audiodestrukt/freedj-nano/hw/puck/cad/renders/INDEX.md

# puck deck render log

- 0001-first-layout-hero.jpg .. 0004-first-layout-section-through-sensors.jpg: 2026-11-11: first layout, 65 dia x 33.1 mm. Waveshare 1.28" round touch LCD on a printed post; the whole top (ring round the glass + knurled side) is the jog, on one 61808 (40 x 52 x 7) with the inner race on the post. A 60-tooth comb under the hub runs through two ITR9608 slotted sensors (quadrature, 240 counts per turn) that stand up from the main PCB through the deck plate. XIAO S3 (USB-C out the back), 402030 LiPo, PCM5102A and jack (left side) in the bay under the plate.
  0001 hero, 0002 top, 0003 inside (face, screen and shell hidden), 0004 section through both sensors
