audiodestrukt/freedj-nano/hw/keychain/cad/renders/0001-first-layout-hero.jpg

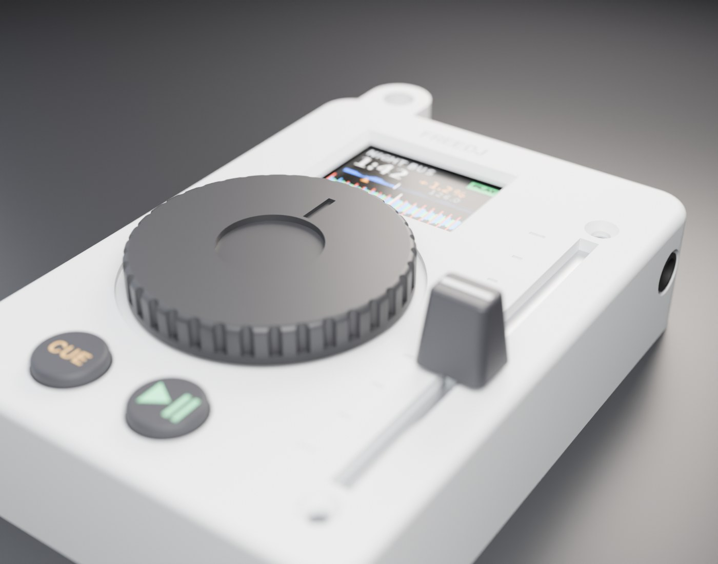
hw/keychain/cad/renders/0001-first-layout-hero.jpg
