audiodestrukt/freedj-nano/hw/keychain/cad/renders/0002-first-layout-top.jpg

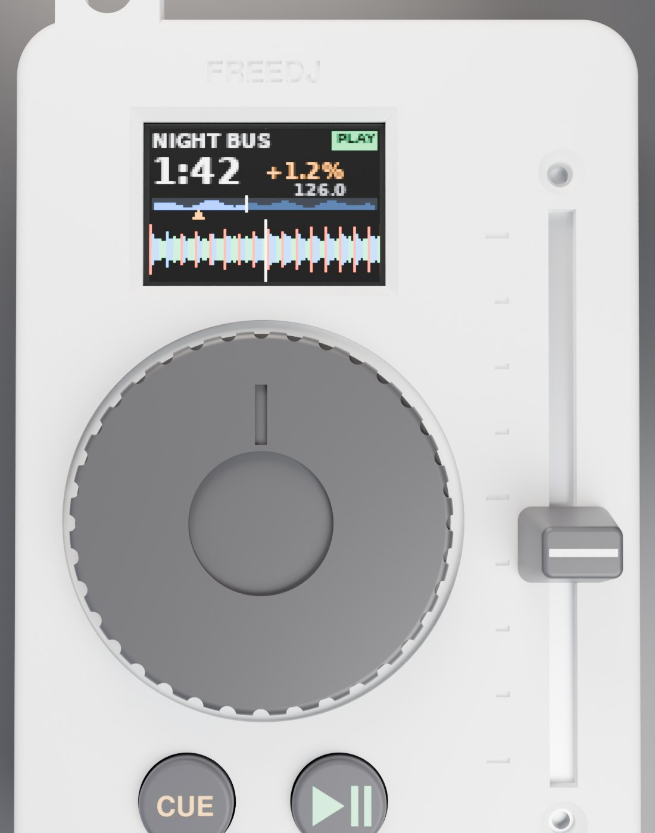
hw/keychain/cad/renders/0002-first-layout-top.jpg
