audiodestrukt/freedj-nano/hw/keychain/cad/renders/0003-back-usb-c-keyring.jpg

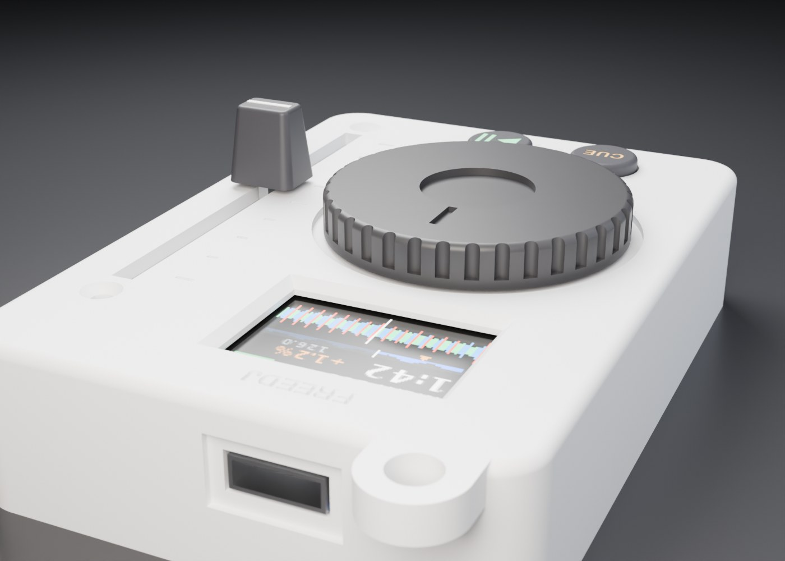
hw/keychain/cad/renders/0003-back-usb-c-keyring.jpg
