audiodestrukt/freedj-nano/hw/keychain/cad/renders/0004-inside-shell-hidden.jpg

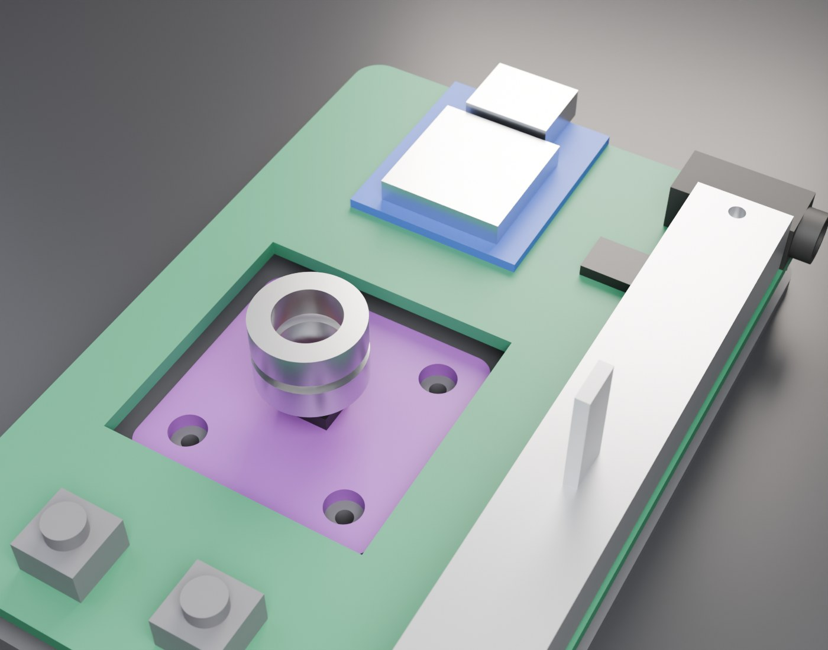
hw/keychain/cad/renders/0004-inside-shell-hidden.jpg
