audiodestrukt/freedj-nano/hw/keychain/cad/renders/0005-section-through-jog.jpg

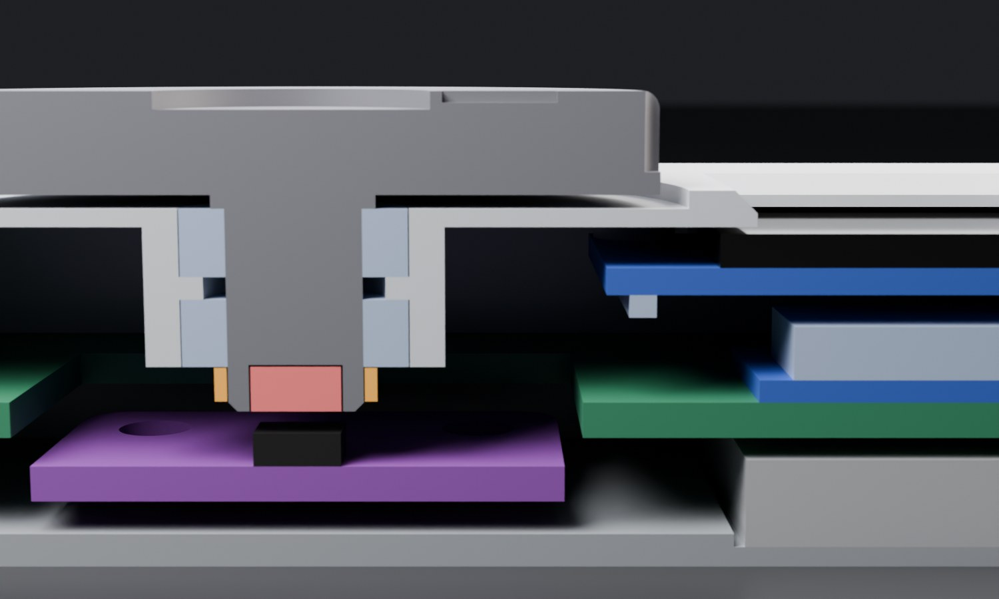
hw/keychain/cad/renders/0005-section-through-jog.jpg
