audiodestrukt/freedj-nano/hw/keychain/cad/renders/0006-cdj-layout-35mm-hero.jpg

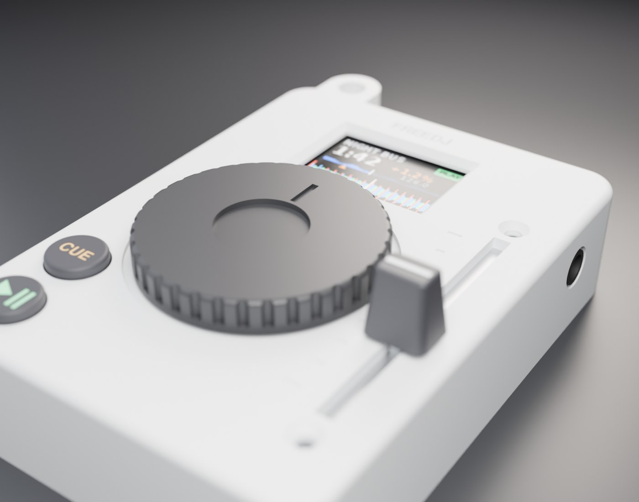
hw/keychain/cad/renders/0006-cdj-layout-35mm-hero.jpg
