audiodestrukt/freedj-nano/hw/keychain/cad/renders/0007-cdj-layout-35mm-top.jpg

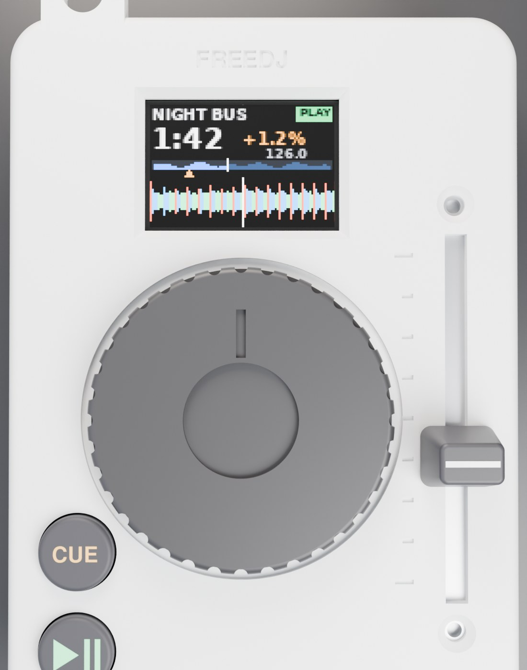
hw/keychain/cad/renders/0007-cdj-layout-35mm-top.jpg
