audiodestrukt/freedj-nano/hw/keychain/cad/renders/0008-cdj-layout-35mm-inside.jpg

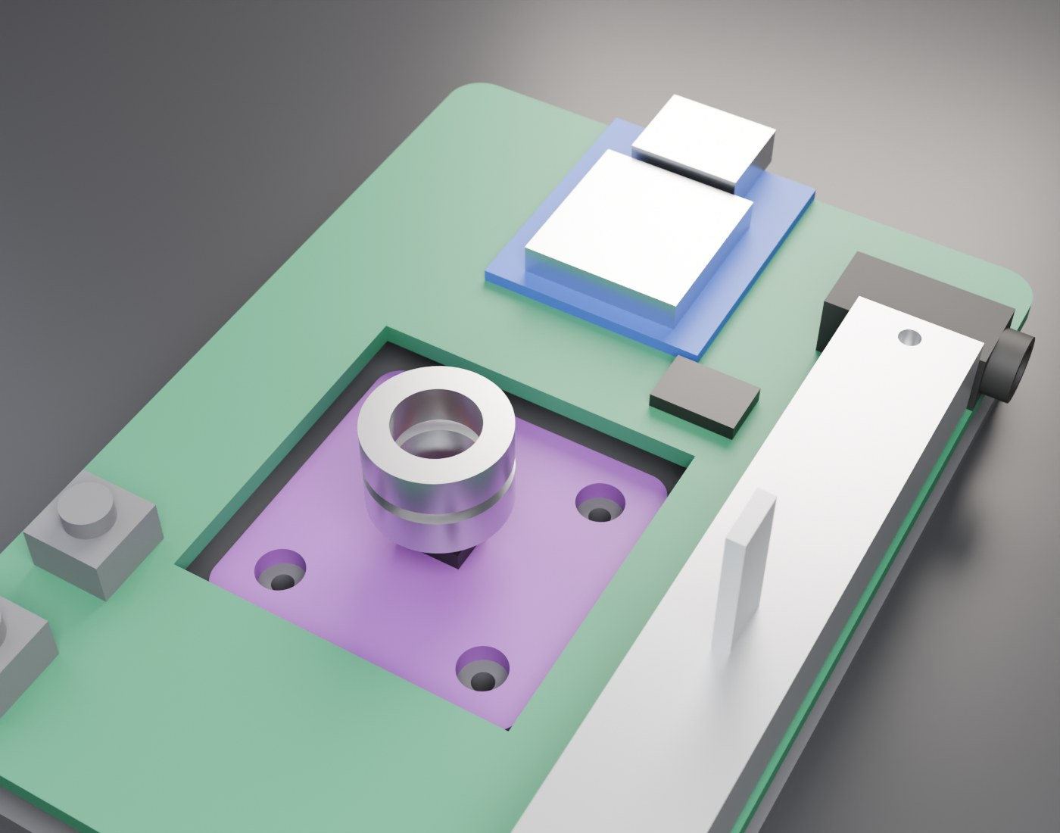
hw/keychain/cad/renders/0008-cdj-layout-35mm-inside.jpg
