audiodestrukt/freedj-nano/hw/keychain/cad/renders/0010-shell-underside-base-bosses.jpg

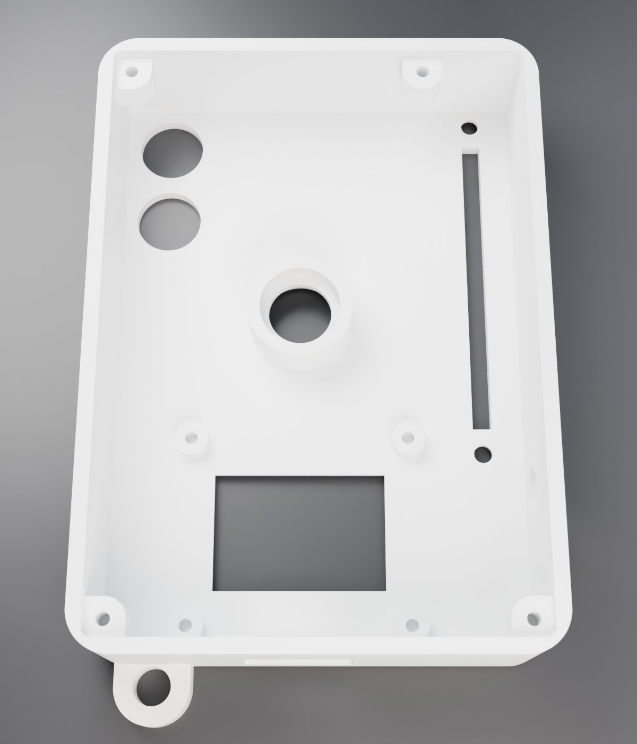
hw/keychain/cad/renders/0010-shell-underside-base-bosses.jpg
