audiodestrukt/freedj-nano/hw/keychain/cad/renders/0011-platter-in-line-with-play-hero.jpg

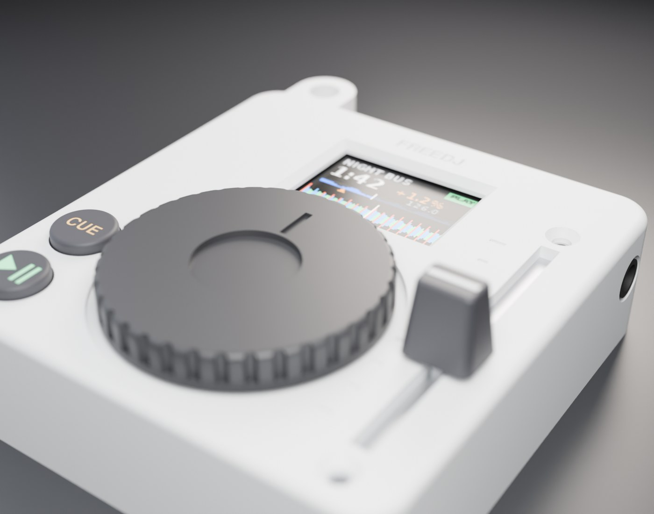
hw/keychain/cad/renders/0011-platter-in-line-with-play-hero.jpg
