audiodestrukt/freedj-nano/hw/keychain/cad/renders/0012-platter-in-line-with-play-top.jpg

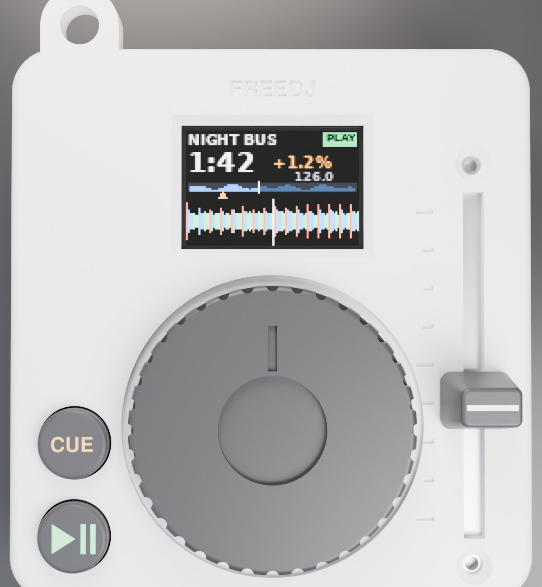
hw/keychain/cad/renders/0012-platter-in-line-with-play-top.jpg
