audiodestrukt/freedj-nano/hw/keychain/cad/renders/0013-platter-in-line-with-play-inside.jpg

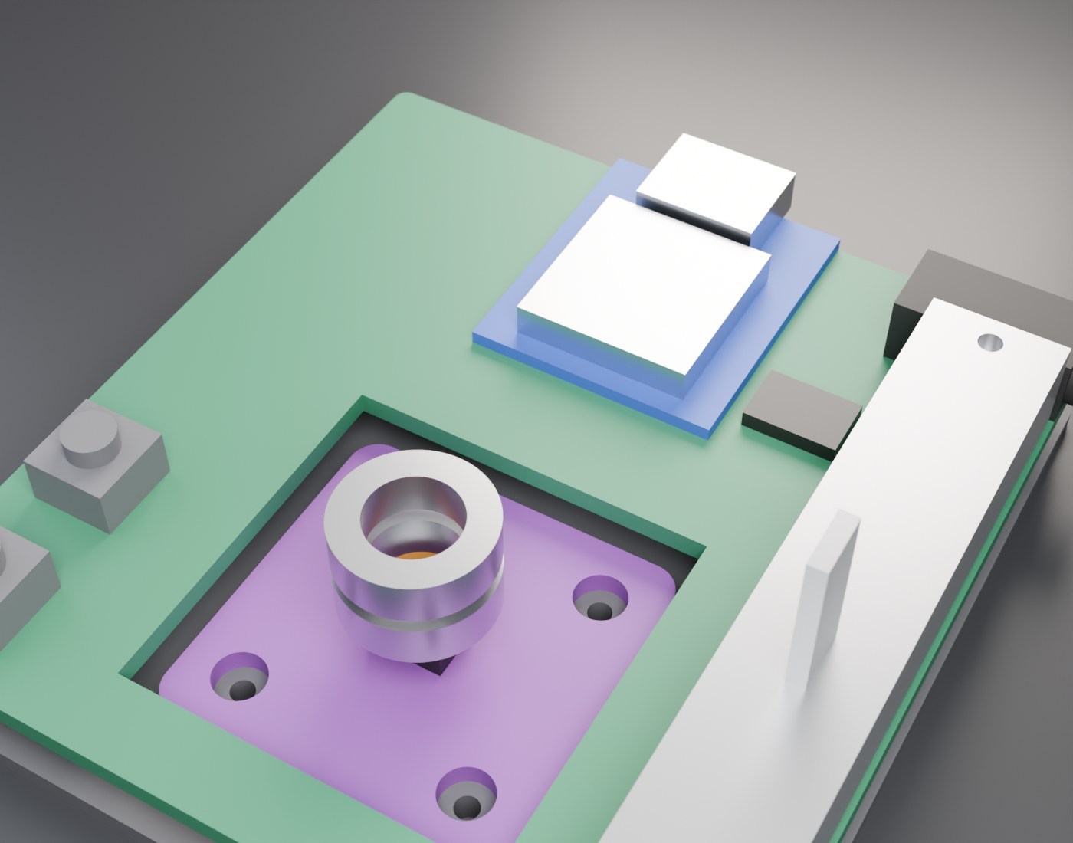
hw/keychain/cad/renders/0013-platter-in-line-with-play-inside.jpg
