audiodestrukt/freedj-nano/hw/keychain/cad/renders/0014-no-keyring-tab-hero.jpg

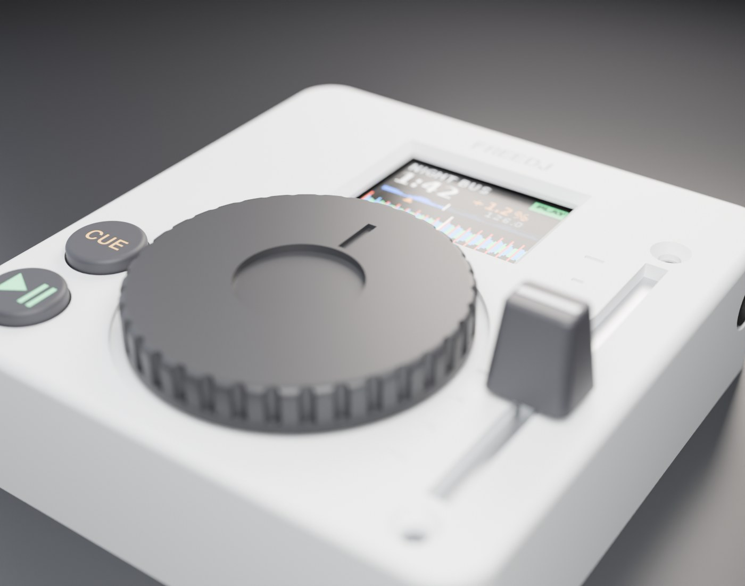
hw/keychain/cad/renders/0014-no-keyring-tab-hero.jpg
