audiodestrukt/freedj-nano/hw/keychain/cad/renders/0016-current-top.jpg

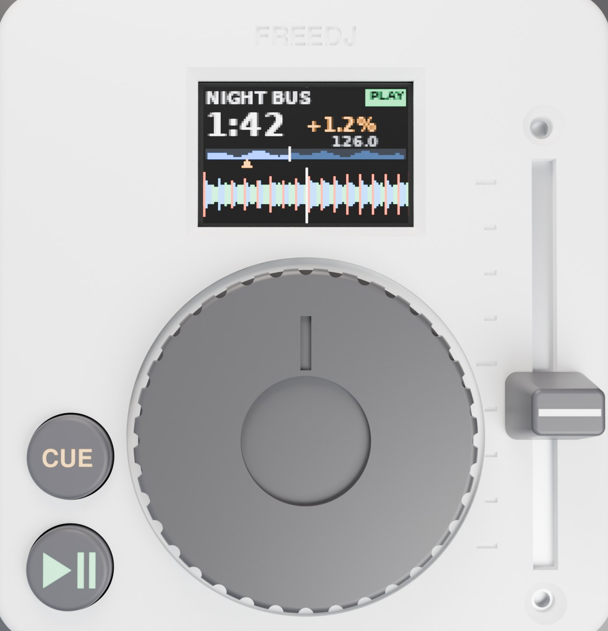
hw/keychain/cad/renders/0016-current-top.jpg
