audiodestrukt/freedj-nano/hw/keychain/cad/renders/0017-current-back-usb-c.jpg

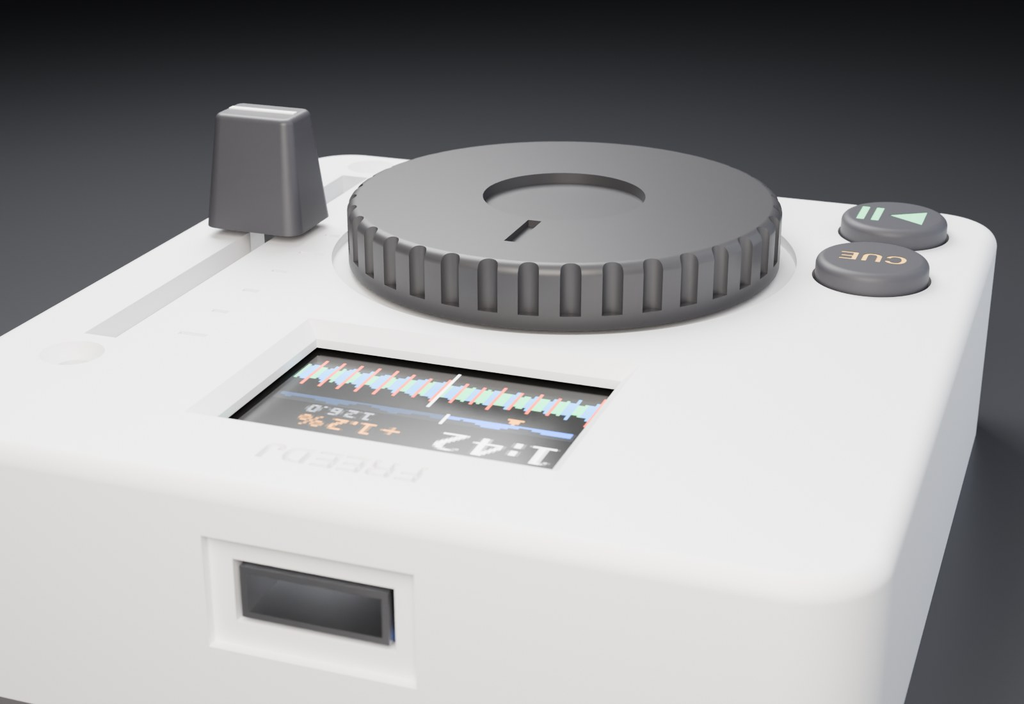
hw/keychain/cad/renders/0017-current-back-usb-c.jpg
