audiodestrukt/freedj-nano/hw/keychain/cad/renders/0018-current-right-side-jack.jpg

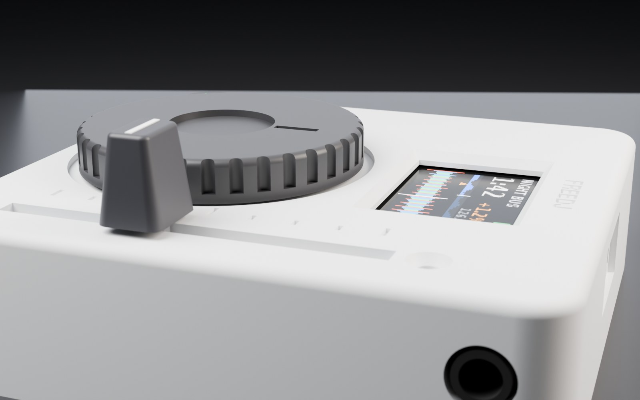
hw/keychain/cad/renders/0018-current-right-side-jack.jpg
