audiodestrukt/freedj-nano/hw/keychain/cad/renders/0019-current-inside-shell-hidden.jpg

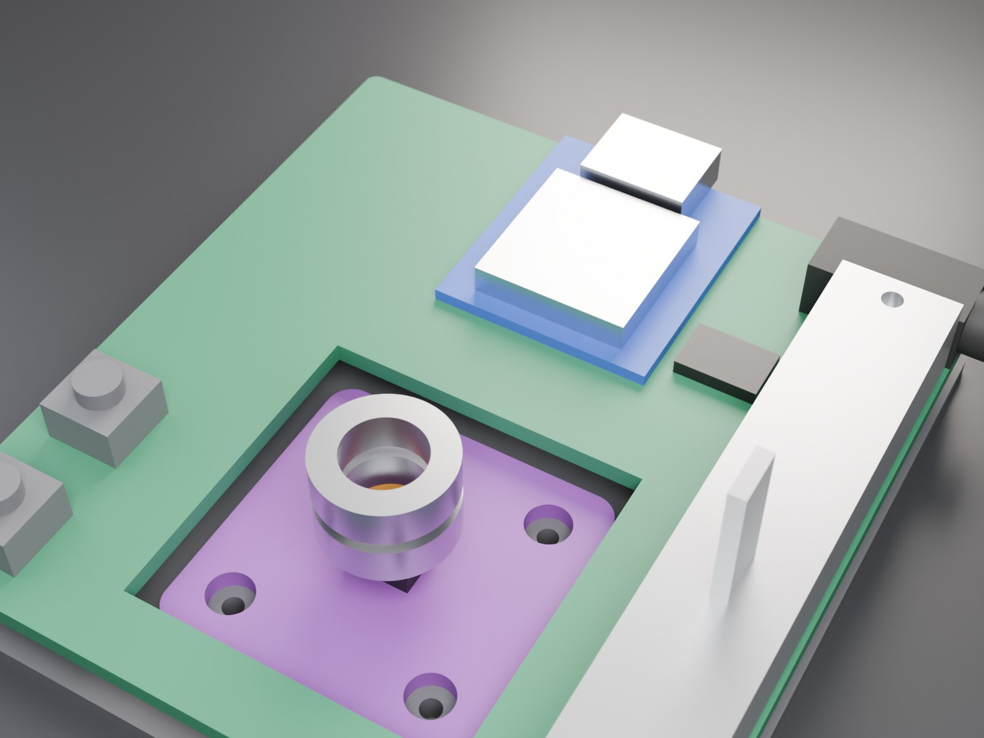
hw/keychain/cad/renders/0019-current-inside-shell-hidden.jpg
