audiodestrukt/freedj-nano/hw/keychain/cad/renders/0020-current-section-through-jog.jpg

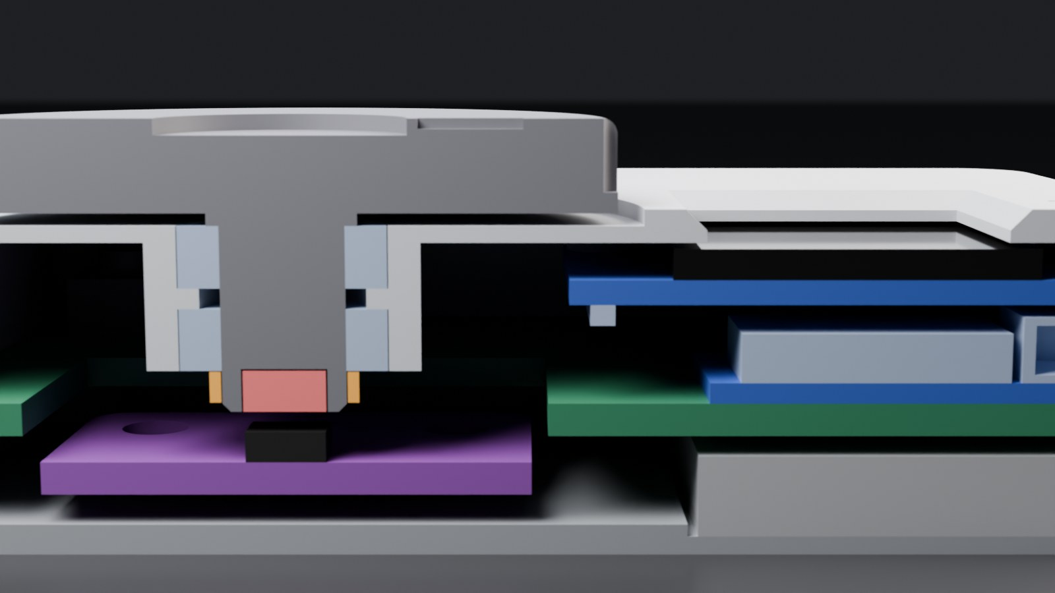
hw/keychain/cad/renders/0020-current-section-through-jog.jpg
