audiodestrukt/freedj-nano/hw/keychain/cad/renders/0021-current-shell-underside.jpg

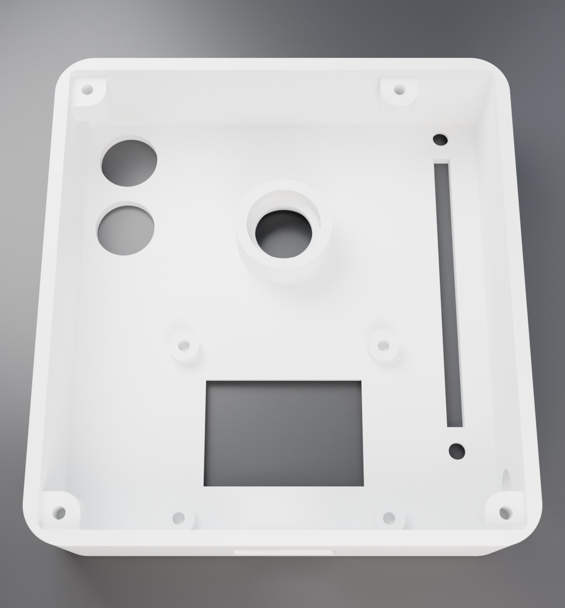
hw/keychain/cad/renders/0021-current-shell-underside.jpg
