audiodestrukt/freedj-nano/hw/keychain/cad/renders/0023-tft20-top.jpg

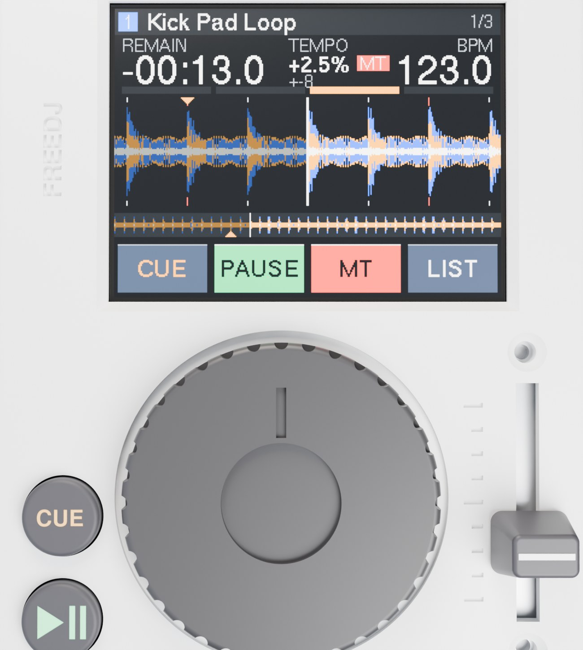
hw/keychain/cad/renders/0023-tft20-top.jpg
