audiodestrukt/freedj-nano/hw/keychain/cad/renders/0024-tft20-left-side-jack.jpg

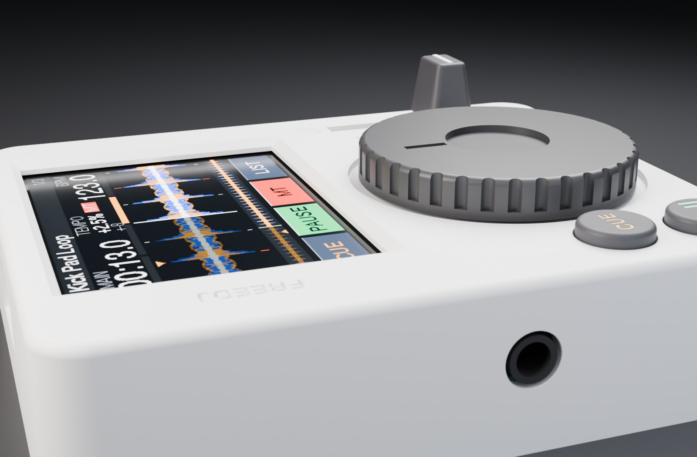
hw/keychain/cad/renders/0024-tft20-left-side-jack.jpg
