audiodestrukt/freedj-nano/hw/keychain/cad/renders/0030-centred-oled095-top.jpg

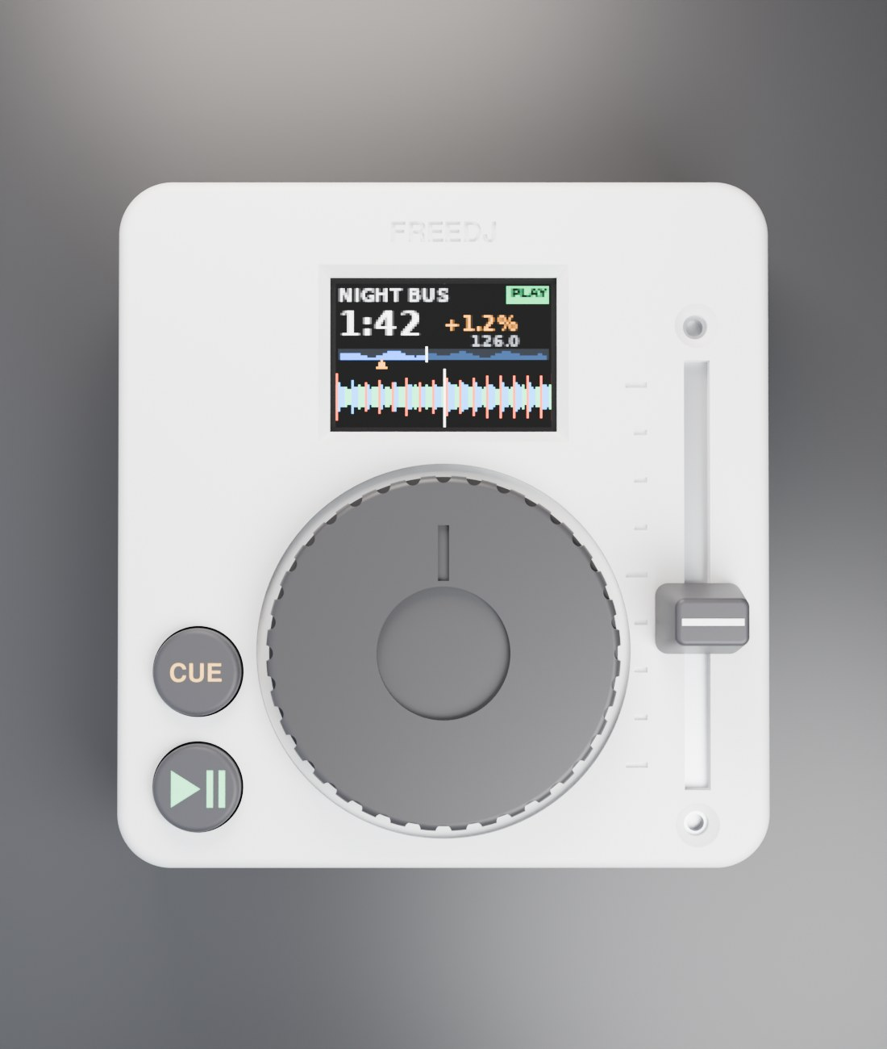
hw/keychain/cad/renders/0030-centred-oled095-top.jpg
