audiodestrukt/freedj-nano/hw/xiao-mini/fab/freedj-nano-xiao-mini-bom-pcbway.csv

Item# | Designator | Qty | Comment | Footprint | Manufacturer Part Number | Manufacturer | LCSC Part No
1 | C1,C8 | 2 | 10uF | capacitor_0805 | CL21A106KAYNNNE | Samsung Electro-Mechanics | C15850
2 | C10,C9 | 2 | 2.2nF | capacitor_0402 | CC0402KRX7R9BB222 | YAGEO | C106861
3 | C2,C3 | 2 | 2.2uF | capacitor_0603 | CL10A225KO8NNNC | Samsung Electro-Mechanics | C23630
4 | C4 | 1 | 1uF | capacitor_0402 | CL05A105KA5NQNC | Samsung Electro-Mechanics | C52923
5 | C5,C6,C7 | 3 | 100nF | capacitor_0402 | CL05B104KO5NNNC | Samsung Electro-Mechanics | C1525
6 | J1 | 1 | PJ_325C5_G | PJ_325C5_G | PJ_325C5_G |  | C692438
7 | J4 | 1 | S2B_PH_SM4_TB_LF__SN_ | S2B_PH_SM4_TB_LF_SN | S2B_PH_SM4_TB_LF__SN_ |  | C295747
8 | R10 | 1 | 4.7k | resistor_res0402 | ERJ2RKF4701X | Panasonic | C400631
9 | R1,R11,R4,R5,R6,R7 | 6 | 10k | resistor_res0402 | 0402WGF1002TCE | UNI-ROYAL(Uniroyal Elec) | C25744
10 | R9 | 1 | 2.2k | resistor_res0402 | 0402WGF2201TCE | UNI-ROYAL(Uniroyal Elec) | C25879
11 | SW5 | 1 | PEC11R_4015F_S0024 | PEC11R_4015F_S0024 | PEC11R_4015F_S0024 |  | C143789
12 | SW1,SW2,SW3,SW4 | 4 | TS_1187A_B_A_B | TS_1187A_B_A_B | TS_1187A_B_A_B |  | C318884
13 | U1 | 1 | PCM5102APWR | PCM5102APWR | PCM5102APWR |  | C107671
