audiodestrukt/freedj-nano/hw/xiao-mini/index.circuit.kicad_pcb

## KiCad design hw/xiao-mini/index.circuit.kicad_pcb (2026-11-10)

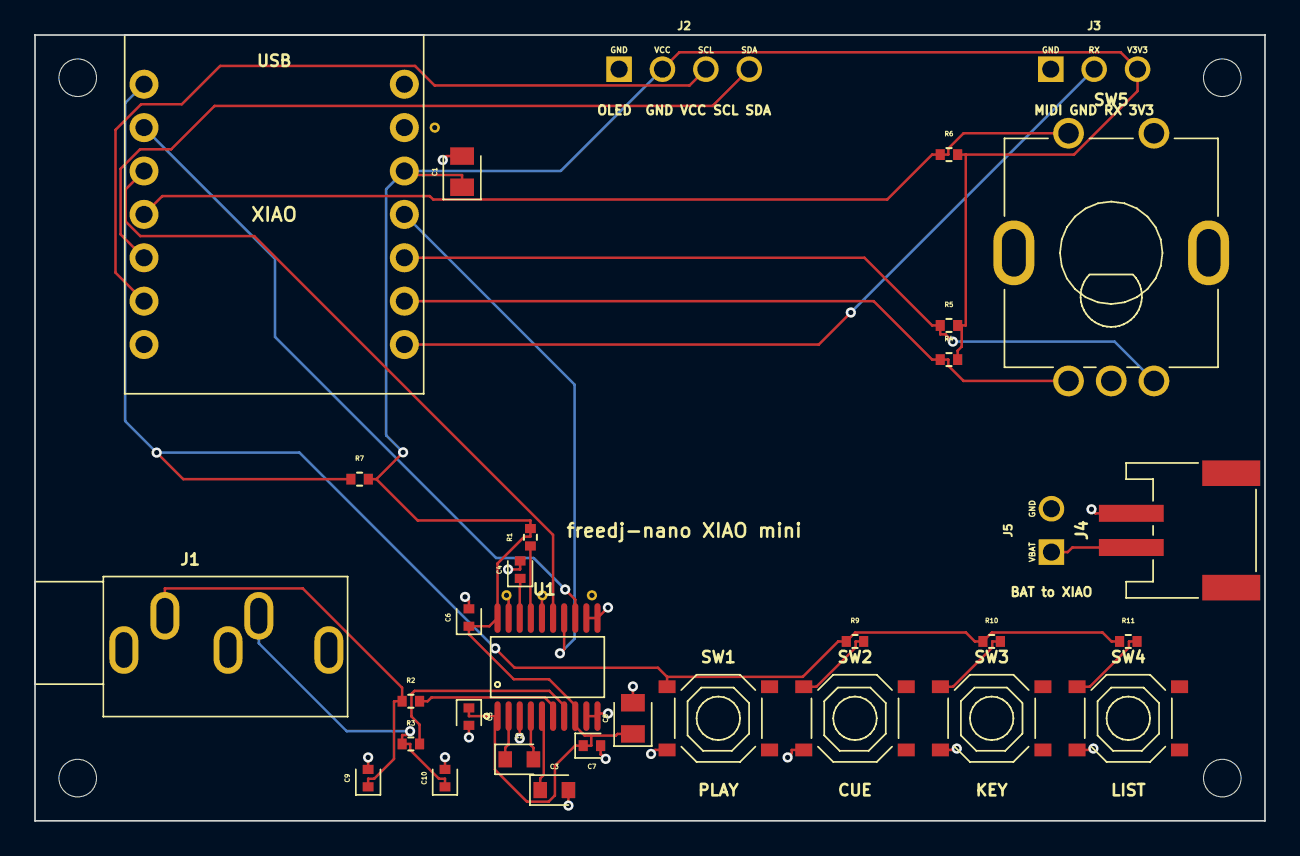
[picture p35: board index.circuit.kicad_pcb from above]

Board: 2 copper layers, 72.0 x 46.0 mm, 36 parts (0 on the bottom side), 25 nets.

Parts:
C1, C8: 10uF; capacitor_0805
C2, C3: 2.2uF; capacitor_0603
C4: 1uF; capacitor_0402
C5, C6, C7: 100nF; capacitor_0402
C9, C10: 2.2nF; capacitor_0402
J1: PJ_325C5_G
J2: J2; pin_header_pinrow4
J3: J3; pin_header_pinrow3
J4: S2B_PH_SM4_TB_LF__SN_; S2B_PH_SM4_TB_LF_SN
J5: J5; pin_header_pinrow2
R1, R4, R5, R6, R7, R11: 10kΩ; resistor_res0402
R2, R3: 470Ω; resistor_res0402
R9: 2.2kΩ; resistor_res0402
R10: 4.7kΩ; resistor_res0402
SW1, SW2, SW3, SW4: TS_1187A_B_A_B
SW5: PEC11R_4015F_S0024
U1: PCM5102APWR
U2: Seeed_XIAO_socketed
V1, V2, V3, V4: via

Connections:
BCK: U1.13, U2.2
C2.pin1 to U1.CAPP: C2.1, U1.2
C2.pin2 to U1.CAPM: C2.2, U1.4
C3.pin1 to U1.VNEG: C3.1, U1.5
C4.pin1 to U1.LDOO: C4.1, U1.18
DIN: U1.14, U2.11
ENC_A: R4.1, SW5.3, U2.13
ENC_B: R5.1, SW5.5, U2.12
ENC_SW: R6.1, SW5.1, U2.4
GND: C1.2, C3.2, C4.2, C5.2, C6.2, C7.2, C8.2, C9.2, C10.2, J1.1, J2.1, J3.1, J4.2, J5.2, SW1.3, SW2.3, SW3.3, SW4.3, SW5.2, SW5.4, SW5.6, SW5.7, U1.3, U1.9, U1.10, U1.11, U1.12, U1.16, U1.19, U2.9, V1.1, V2.1, V3.1, V4.1
JL: C9.1, J1.2, R2.1
JR: C10.1, J1.3, R3.1
LADDER: R7.1, R9.1, R10.1, R11.1, SW1.1, U2.1
LRCK: U1.15, U2.3
MIDI_RX: J3.2, U2.14
R1.pin1 to U1.XSMT: R1.1, U1.17
R2.pin2 to U1.OUTL: R2.2, U1.6
R3.pin2 to U1.OUTR: R3.2, U1.7
R9.pin2 to SW2.A: R9.2, SW2.1
R10.pin2 to SW3.A: R10.2, SW3.1
R11.pin2 to SW4.A: R11.2, SW4.1
SCL: J2.3, U2.6
SDA: J2.4, U2.5
V3V3: C1.1, C5.1, C6.1, C7.1, C8.1, J2.2, J3.3, R1.2, R4.2, R5.2, R6.2, R7.2, U1.1, U1.8, U1.20, U2.10
VBAT: J4.1, J5.1
