audiodestrukt/freedj-nano/(commit log)

2026-11-09 nano core (components/nano): fixed-point keylock (WSOLA reading memory-mapped PCM directly: 50% overlap sin^2, coarse+fine AMDF, ~40 B state; pitch, speed and level hold at 0.5/0.8/1.25/2x), varispee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
    [deck.h, deck_event.h, dj2go.h, gfx.h]
2026-11-09 firmware (ESP-IDF 5.5, ESP32-C6): I2S to PCM5102A (BCK 64 fs, no MCLK), EC11 on PCNT, GPIO or one-pin ladder buttons, pitch pot, DIN MIDI on UART1, tracks partition memory-mapped, u8g2 backend (SSD13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
    [partitions.csv]
2026-11-09 tools and docs: pack_tracks.py (ffmpeg -> track pack with 10 ms peaks, round-trips through the C++ reader), build.sh (all configs in Docker + host tests), README (scope vs freedj-esp, displays, pin m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
2026-11-09 firmware: serial bench console over USB (p/c/k/+/-/0/r/n/b/j/J/l/?), budget line shows state, track, position, tempo. First run on the XIAO ESP32C6: plays, cues, tempo and keylock from the console; a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
2026-11-09 xiao_tft: XIAO + 3.2" ILI9341 (SCK D8, MOSI D10, CS D3, DC D9, I2S DOUT to D6). Ladder pin pulled up (floating, it held CUE at boot). Banded TFT: layout skips work outside the band (was 15x), 48-row 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
    [board.h, display_tft.cpp, gfx.h, inputs.cpp]
2026-11-09 README: the XIAO drives the 3.2" touch TFT (xiao_tft: 28.5 fps, 17.6 ms/frame at 40 MHz), pin map; OLED + encoder stays the default XIAO build
2026-11-09 TFT: IPS voltage preset at boot on IPS panels (driver's TN defaults left sharp shadows of the waveform below it on the 3.2" ILI9341V), live tuning keys (i/v/V/f, R/a). Per-row change hashes: send onl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
2026-11-09 docs/DESIGN.md: design decisions and the thinking behind them (separate repo, fixed-point random-access keylock, own renderer + u8g2 for OLEDs, banded TFT steps 20 -> 53 fps, the ghosting chase to th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
2026-11-09 DESIGN.md: why Pro DJ Link is the tight fit (Wi-Fi bursts on the one core, flash writes stall memory-mapped tracks, wired = W5500 sharing the TFT's only SPI bus, Link over Wi-Fi jitter), and the test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
2026-11-09 CDJ-3000 look on the color layouts (freedj-esp palette): REMAIN / TEMPO + MT / BPM at tempo, beat-in-bar meter, 3-band waveform (blue/orange/white) with beat and bar ticks, coloured overview, key-sty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
2026-11-09 rekordbox: tools/rekordbox.py reads USBANLZ (PPTH path, PQTZ beat grid, PWV7 CDJ-3000 3-band waveform; byte order low/mid/high settled by correlation with our band filters). pack_tracks.py --rekordbo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
2026-11-09 docs/TARGETS.md: the RP2350 (second real target: two cores, XIP flash, PIO I2S, USB host; port plan per firmware module) and the CH32V003 (10-cent experiment: PWM audio, SPI flash, 2 KB RAM, keylock 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
2026-11-09 docs/DECK10C.md: plan for the 10-cent DJ deck on the CH32V003 (WCH-LinkE over SWIO, W25Q128 tracks via CH341A, dual-PWM audio, SSD1306 128x32 page renderer, EC11/buttons/pot, DJ2Go over the WCH-LinkE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
2026-11-09 DECK10C.md: microSD (SPI, Petit FatFs) as the default track storage, W25Q128 as the fallback; tracks stream forward through a ~0.6-1 KB ring (keylock's reads stay near the playhead, so no random seek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
2026-11-10 audio: I2S ws_width = 32 to match the 32-bit slots: the default (data width, 16) flipped WS mid-slot and the PCM5102A lost the right channel. First sound on the XIAO TFT build (BCK D1, LRCK D2, DIN D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
    [audio.cpp]
2026-11-10 stretch: search +-1 hop (11.6 ms) instead of +-hop/4 (2.9 ms): bass under ~200 Hz couldn't line up and followed the tempo (50-120 Hz 7.7-7.9 % sharp at +8 %), now within 0.25 % from 45 Hz up. Coarse 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
2026-11-10 ch32v003: nano-lite, phase 0 of the 10-cent deck. Engine in C for RV32EC: mu-law track through a 768 B ring + 192 B decimated copy, varispeed, keylock with the +-1 hop search clamped to the rings. 83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
2026-11-10 ch32v003: PWM output modelled; centre-aligned TIM1, R2 267k, Sallen-Key filter
    sim/pwm_sim.py (make pwm): two PWM pins, the 1:256 resistor sum (tolerances, pin
    resistance) and the filter solved exactly per PWM period; checked against tick
    stepping (4e-14 V) and ngspice (0.000 dB). THD+N at 1 kHz -6 dBFS:
    edge-aligned -47.8 dB (pulse centre moves with duty), centre-aligned -76.2 dB.
    At -40 dBFS: R2 255k -36.3, 267k -43.6; one 8-bit pin -14.1. mu-law track
    itself -37.6. Sallen-Key: ripple 55 -> 6 mVpp. 2x interp: 5 kHz image -26 -> -35 dB.
    [pwm_sim.py]
2026-11-10 nano-lite: lite_pos() continuous in keylock (was a hop behind at each hop's end)
    Found by the whole-deck sim: the reported position jumped back 231 frames every
    11.6 ms in keylock (i == 0 read as the start of the last hop, not its end), and
    by hop x (1 - speed) on a jump (-112 at 0.5x). Now ana + hop - (hop - i) x speed:
    continuous across hops and from a jump. Used for the display, cue points set
    while paused, the end of the track and engine switches. New test: position
    never goes backwards, keylock and varispeed, 0.5-1.5x. 93 checks pass.
2026-11-10 ch32v003/fw: the deck firmware behind a small HAL
    app.c: CDJ transport (CUE back to the cue / set and preview, PLAY), EC11 jog
    (nudge playing, search paused), SHIFT + turn list, push keylock, SHIFT + push
    tempo range, pitch pot, the DJ2Go over midi_bridge.py (0x01 + USB-MIDI) and
    console keys. ui.c: SSD1306 128x32, one page per step by DMA, 20 fps. sd.c: SD
    over SPI with a held-open CMD18 stream (SD_STREAM=0: CMD17 per read). tracks.c:
    TRACKS.BIN read by sector once it's found contiguous. pff/: Petit FatFs R0.03a
    (ChaN, 1-clause BSD), mount and open only, FAT32, plus pf_contig().
2026-11-10 ch32v003/sim: the deck on the computer, on emulated parts; 31 checks
    sim/emu: an SDHC card in SPI mode (CMD0/8/55/41/58/16/17/18/12, access time as
    0xFF bytes) and an SSD1306 from its I2C stream. sim/host: the firmware in an SDL
    window with sound, the panel on the keyboard, a pty for midi_bridge.py or the
    DJ2Go direct; headless scripted sessions (status lines, WAV, PNG screenshots).
    tools: pack_lite.py (TRACKS.BIN), sdimage.py (FAT32 image, MBR, 32 KB clusters,
    --fragment). test_sim.py: transport, search, preview, keylock pitch through the
    whole chain (440 Hz at +9.8 %), list, DJ2Go, console keys, end of track,
    fragmented file, no card. SD at 1x: CMD18 stream 32 KB/s (1 % of the bus) vs
    CMD1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
2026-11-10 ch32v003: whole firmware counted in qemu (make deckbench); fits, 14 % CPU
    The same firmware for RV32EC with the emulators linked in and left out of the
    count, a 10.5 s scripted session; SPI byte wait charged as instructions. At 1.5
    cycles/instruction: flash 10.8 KB (+ ~1.5 KB drivers = ~12.1 of 16 KB), RAM
    1403 B + 256 B DMA ring + 364 B stack = 2023 of 2048 B, CPU 14 % (engine 9 %),
    worst main-loop step 95 k instructions = 68 % of the ring (list view).
    CMD17 reads instead: 66 % CPU, worst step 303 %: audio would drop.
2026-11-10 ch32v003: 128x64 OLED (0.96"): big time, beat meter, cue time, 7-row list
    Same one-page buffer, so no more RAM for twice the screen. Pages: name; time
    left at 2x with BPM at tempo and tempo; state, inverted KEY, range; four-beat
    bar meter from the beat grid; elapsed and cue; 16 px overview. List: header +
    7 names. SSD1306 emulator follows the multiplex ratio (64 or 32 rows).
    deckbench: flash 11.5 KB (+0.6), RAM 2027/2048 B (+4), CPU 15 % (+0.5), worst
    step 105 k instructions = 75 % of the ring (list view, was 68 %). 31/31 sim.
    [app.c, app.h, main.c, ui.c, ui.h]
2026-11-10 ch32v003: scrolling waveform; deckbench cycle model; CPU and fps in the sim
    Waveform on pages 4-6: 1.5 s around the playhead, 23 px mirrored, min 1 px,
    beat ticks, cue notch; peaks (1 per 256 frames) read from TRACKS.BIN into the
    page buffer, no RAM. Petit FatFs state borrows the page buffer at mount: RAM
    1998/2048 B. deckbench cycle model (flash wait state, loads, taken branches):
    2.57 CPI, 37 % CPU, worst step 135 % of the ring -> audio would drop (two SD
    stream restarts per waveform page); without the waveform 22 % / 91 %. Sim
    window: estimated CPU (35.5 % vs 37 %), worst step, fps. 31/31 sim checks.
2026-11-10 nano-lite: play backwards (negative speed, varispeed) for scrubbing
    A backwards read below the 35 ms ring refills it with the playhead near its top:
    one forward card read per ~700 frames back. Forward reads below the ring still
    count as misses. Tests: 440 Hz backwards at 1x, 2.5x, 0.3x (pitch within 1 %,
    travel within 64 frames, no misses, no steps beyond the tone's own), and a 2 s
    back-and-forth scratch at 3x returns to within 300 frames. 106 checks.
2026-11-10 docs: DECK10C-CONTROLS.md, jog / browse / button options for the CH32V003 deck
    Undecided, written up: 16 of 16 pins used (pot on PD5, the unused USART TX).
    Jog: EC11 (80-120 counts, 3 pins), AS5600 on the shared I2C (4096, 0 pins),
    or a slotted printed wheel + two slot sensors on TIM2 encoder mode (4N counts,
    ~300-400; 2 pins, no CPU; sensors (k + 1/4) pitches apart). Side thumbwheel
    for browse; binary-weighted resistor ladder for the buttons (CUE + PLAY must
    read). Pin plans for each; a one-turn DJ2Go test.
2026-11-10 docs: CHIPS.md, chip options and what each would sound like
    CH32V003 limits (2 KB RAM, no I2S, no multiply, 16 pins, no USB host) against
    CH32V002 / V006 (8 KB) / V203 (20 KB+, 144 MHz, USB host, 2 SPI, no I2S per its
    tables) / V30x (I2S, FPU) / RP2350. Scenarios: V003 as is; V006 for 16-bit mono
    or safety margin; V203 + PCM5102A for 16-bit stereo 44.1 kHz via SPI + a timer
    for LRCK, DJ2Go on the USB host; V30x; RP2350. Things to check before choosing.
2026-11-10 hw/xiao-mini: carrier board for the XIAO ESP32-C6 deck (routed, DRC clean)
    72 x 46 mm, 2 layers, tscircuit source routed headless (pcb-layout route2: Freerouting
    through KiCad, srj compared). Wires the C6 firmware's XIAO OLED pin map: PCM5102A -> 3.5 mm
    line out (D1/D2/D10), OLED header (D4/D5), EC11 + push (D8/D9/D3), 4-button ADC ladder on D0
    (0/2k2/4k7/10k), MIDI-in header (D7), JST-PH LiPo + pads to the XIAO's BAT pads.
    Result: 0 shorts, 0 open, 0 DRC errors (JLCPCB rules), DFM clean, no floating pads; 25 vias,
    762 mm of track. fab/: Gerbers, drill, CPL, JLCPCB + PCBWay BOMs (20 parts assembled).
    To check before ordering: jack pinout (assumed 1 sleeve / 2 tip / 3 ring), OLED pin order,
    a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
    [freedj-nano-xiao-mini-bom-pcbway.csv, freedj-nano-xiao-mini-bom.csv, freedj-nano-xiao-mini-handsolder.csv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]
2026-11-11 hw/keychain: pocket deck enclosure for the XIAO ESP32-S3 (CDJ layout, fit-checked)
    60 x 63.6 x 16.9 mm build123d enclosure: 0.95" colour OLED over a 32 mm jog on two
    MR106ZZ and the AS5600 breakout, CUE over PLAY bottom-left with the platter in line
    with PLAY, 35 mm pitch fader from the front edge, LiPo, PCM5102A + jack, USB-C out
    the back. make builds the STLs and checks all 28 parts for overlap (none). Renders
    and their log in cad/renders/.
2026-11-11 hw/puck: round deck, whole top is the jog on a 61808, opto comb encoder (fit-checked)
2026-11-11 hw/cad: make installs its own deps, builds and renders on macOS
    - hw/cad.mk (shared by both CAD Makefiles): creates hw/.venv from
    cad-requirements.txt on first make (uv with Python 3.12 if present),
    finds Blender on PATH / macOS / the old Linux path. PY=... skips the venv.
    - machine.py: fit check works on build123d 0.13 (no Vector.to_tuple, a
    non-touching intersection returns None).
    - machine.py: GLBs carry normals, split at 30 degree creases, so viewers
    stop smoothing hard edges (the puck post's holes looked like dimples).
    - screen_mock.py: fall back to Arial where DejaVu is not installed.
    - render.py: try the Metal backend; a missing backend no longer raises.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
2026-11-12 hw/puck: post's bearing lead-in chamfer was cut inside out, leaving a thin lip at the top
2026-11-13 hw/keychain: 0.95" OLED board stands portrait, measured M2 holes 23.5 x 26.75
    The listing had the hole rectangle the other way round. Visible panel measured 25 x 17;
    board outline and the glass's 0.3 mm shift toward the pins scaled from a photo (MEASURE).
    oled095 is now 60.4 x 66.7 x 16.9, fit check clean.
2026-11-13 hw/keychain: OLED case takes the 45 mm fader, M2 holes measured 40.5 apart
    30 mm travel and a 45 mm frame assumed from the holes (MEASURE); the 2" case keeps its
    20 mm fader (a longer one runs under that screen's board). The DAC now follows the jack,
    which moved 5 mm forward with the shorter frame. Script docstrings point at build/<screen>/.
    Fit check clean on both cases.
